Axagon6/OpenBook/Images/Image1.png

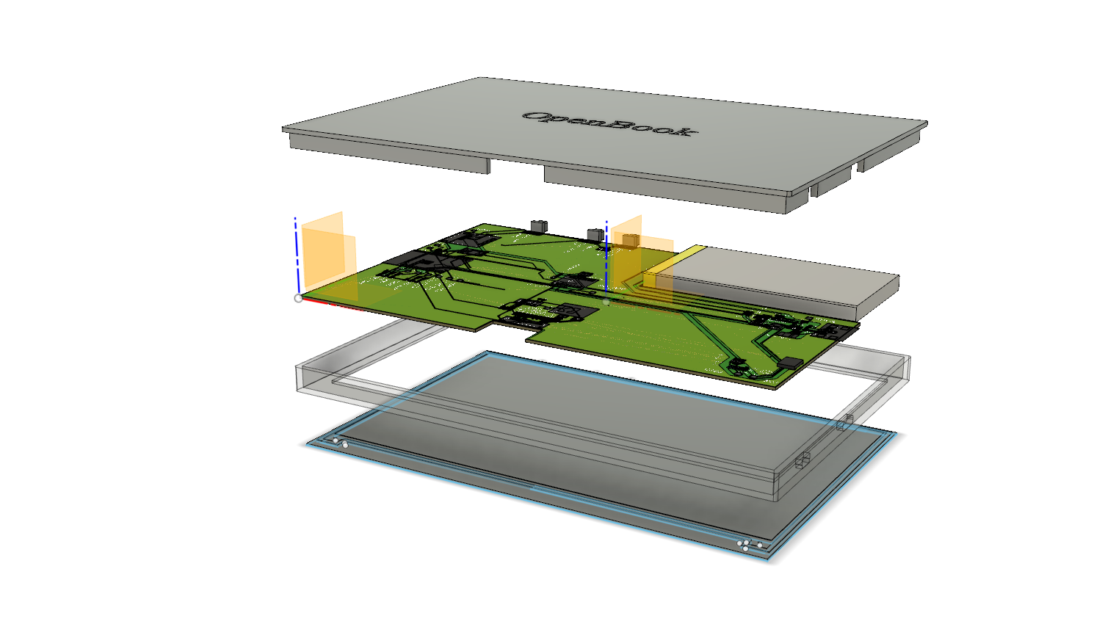
Images/Image1.png
