Axagon6/OpenBook/Images/Image2.png

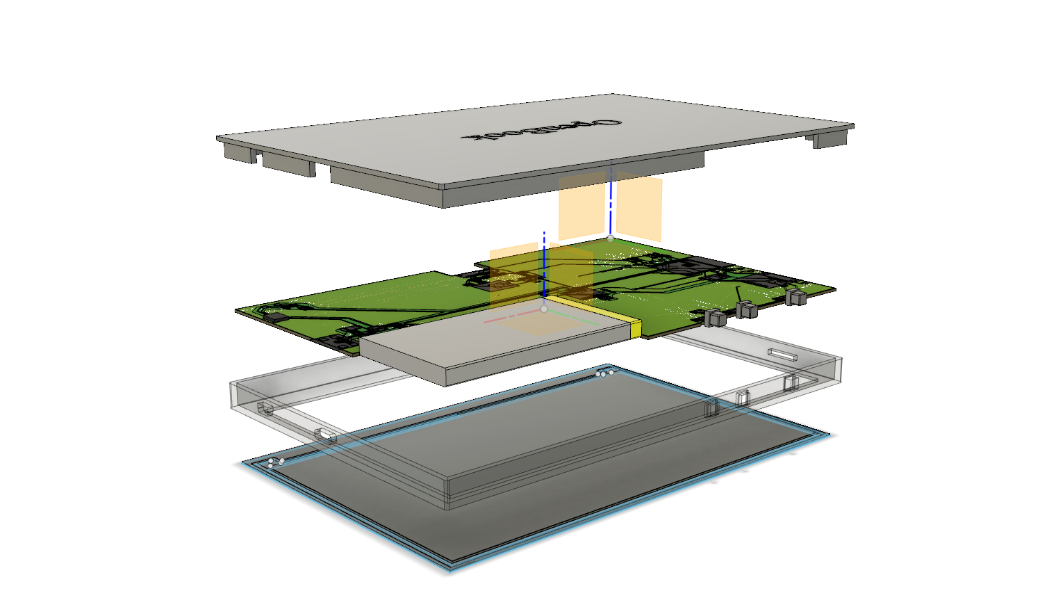
Images/Image2.png
