Axagon6/OpenBook/Images/Image3.png

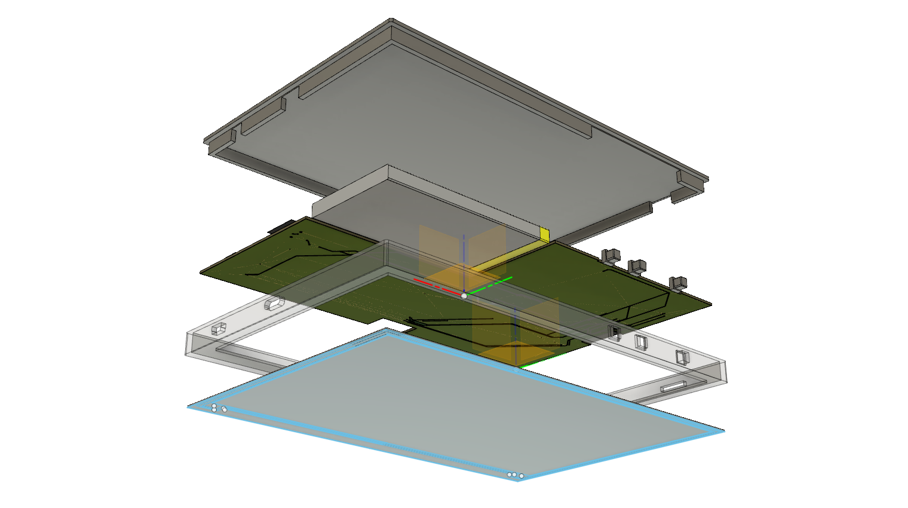
Images/Image3.png
