Axagon6/OpenBook/Manufacturing/BOM_E-book_PCB v25.txt

Partlist exported from Fusion Hub: Hub1   Project: TSC project  Board: E-book_PCB v25 at 06.04.2025 12:42

Qty Value                                                                          Device                                                                         Package                                                Parts                                                                                                                      Description                                                                                                                                                                                                                                                                                                                                                                                                                                                                                          ARROW_PART_NUMBER ARROW_PRICE-STOCK AVAILABILITY CENTROID_NOT_SPECIFIED CHECK_PRICES                                                                           COPYRIGHT                                                DATASHEET                              DESCRIPTION                                                                                        DIGIKEY_DESCRIPTION                                                                                                                                                                                                      DIGIKEY_PART_NUMBER                           HEIGHT                                                                                LEAD_FREE                                                          MANUFACTURER_NAME                 MANUFACTURER_PART_NUMBER MF                  MFR_NAME          MOUSER_PART_NUMBER    MOUSER_PRICE-STOCK                                                                                        MOUSER_TESTING_PART_NUMBER MOUSER_TESTING_PRICE-STOCK MP                                                                                                                  MPN                                                                                                  PACKAGE                     POPULARITY          PREFIX PRICE                        PROD_ID    PURCHASE-URL                                                                                                                                ROHS SNAPEDA_LINK                                                                       SPICEMODEL                                                                                                                                      SPICEPREFIX TEMPERATURE_RANGE_HIGH                                                                  TEMPERATURE_RANGE_LOW TP_SIGNAL_NAME VALUE             
1                                                                                  ADAFRUIT_LEDCHIP-LED0603                                                       ADAFRUIT_CHIP-LED0603                                  CHG_LED                                                                                                                    LED                                                                                                                                                                                                                                                                                                                                                                                                                                                                                                                                                                                                                                                                                                                                                                                                                                                                                                                                                                                                                                                                                                                                                                                                     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
1   BD5229G-TR                                                                     BD5229G-TR                                                                     SOT95P280X125-5N                                       IC1                                                                                                                        Voltage Detector with Adjustable Delay Time: CMOS processes are utilized to develop high precision, low current consumption CMOS reset ICs that allow arbitrary setting of the delay time. The extensive lineup includes both Nch Open Drain and CMOS output types in a wide range of detection voltages (from 2.3V to 6.0V, in 0.1V steps), enabling selection of the ideal solution based on customer requirements. In addition, the entire series is of course both lead-free and RoHS-compliant.                                                                                                                                                                                                                                                                Voltage Detector with Adjustable Delay Time: CMOS processes are utilized to develop high precision  low current consumption CMOS reset ICs that allow arbitrary setting of the delay time. The extensive lineup includes both Nch Open Drain and CMOS output types in a wide range of detection voltages (from 2.3V to 6.0V  in 0.1V steps)                                enabling selection of the ideal solution based on customer requirements. In addition  the entire series is of course both lead-free and RoHS-compliant.                                                            1.25mm                                ROHM Semiconductor    BD5229G-TR                                                                                                                                                      755-BD5229G-TR                                                                                                      https://www.mouser.co.uk/ProductDetail/ROHM-Semiconductor/BD5229G-TR?qs=4kLU8WoGk0vvnhrrYwdszw%3D%3D                                                                                                                                                                                                                                                                                                                                                                                                                                                                                                                                                                                                                                               
3   BUTTON_CUSYOMV1                                                                BUTTON_CUSYOMV1                                                                MYBUTTON                                               BOOT_BUTTON, CHANGE_BUTTON, RESET_BUTTON                                                                                                                                                                                                                                                                                                                                                                                                                                                                                                                                                                                                                                                                                                                                                                                                                                                                                                                                                                                                                                                                                                                                                                                                                                                                                                                                                                                                                                                                                                                                                                                                                                                                                                                                                                                                                                                                                                                                                                                                                                                                                                                                                                                                                                                                                                                                                                                                                                                                                                                                                        
1   CPH3225A                                                                       CPH3225A                                                                       CAPCP3225X100N                                         C10_SUPERCAP                                                                                                               Cap 0.011F 3.3V 1210 Flat Check availability                                                                                                                                                                                                                                                                                                                                                                                                                                                                                             Not in stock                        https://www.snapeda.com/parts/CPH3225A/Seiko+Instruments/view-part/?ref=eda                                                                                                             11 mF (EDLC) Supercapacitor 3.3 V 1210 (3225 Metric) - -                                                                                                                                                                                                                                                                                                                                                                                                                                                                                                                                     Seiko Instruments                                                                                                                                                                                                           CPH3225A                                                                                                                                                                                                                 1210 Seiko                                             None                                    https://www.snapeda.com/api/url_track_click_mouser/?unipart_id=562593&manufacturer=Seiko Instruments&part_name=CPH3225A&search_term=None         https://www.snapeda.com/parts/CPH3225A/Seiko+Instruments/view-part/?ref=snap                                                                                                                                                                                                                                                                                                                  
1   DS3231SN#                                                                      DS3231SN#                                                                      SOIC127P1032X265-16N                                   U3                                                                                                                         Real Time Clock Serial 16-Pin SOIC W T/R     Check availability                                                                                                                                                                                                                                                                                                                                                                                                                                                                          In Stock                            https://www.snapeda.com/parts/DS3231SN%23/Analog+Devices/view-part/?ref=eda                                                                                                             Extremely Accurate I²C-Integrated RTC/TCXO/Crystal                                                                                                                                                                                                                                                                                                                                                                                                                                                                                                                                           Analog Devices                                                                                                                                                                                                              DS3231SN#                                                                                                                                                                                                                SOIC-16 Maxim                                          None                                    https://www.snapeda.com/api/url_track_click_mouser/?unipart_id=99048&manufacturer=Analog Devices&part_name=DS3231SN#&search_term=None            https://www.snapeda.com/parts/DS3231SN%23/Analog+Devices/view-part/?ref=snap                                                                                                                                                                                                                                                                                                                  
1   ESP32-C6-WROOM-1-N8                                                            ESP32-C6-WROOM-1-N8                                                            XCVR_ESP32-C6-WROOM-1-N8                               U2                                                                                                                         Check availability                                                                                                                                                                                                                                                                                                                                                                                                                                                                                                                       In Stock                            https://www.snapeda.com/parts/ESP32-C6-WROOM-1-N8/Espressif+Systems/view-part/?ref=eda                                                                                                  Multiprotocol Modules ESP32-C6 module                                                              Wi-Fi 6 in 2.4 GHz band                                                                                                                                                                                                  Bluetooth 5                                   Zigbee 3.0 and Thread. ESP34-WROOM Compatible - ENGINEERING SAMPLE                                                                                                                                                                                                             Espressif Systems                                                                                                                                                                                                                                                                                                                                                                                                    ESP32-C6-WROOM-1-N8        None                                                                                                                                                                                None                                                                                                                                                                                                                                                https://www.snapeda.com/parts/ESP32-C6-WROOM-1-N8/Espressif+Systems/view-part/?ref=snap                                                        
1   ESP32C6_VARISTORCN1812                                                         ESP32C6_VARISTORCN1812                                                         ESP32C6_VARISTOR_CT/CN1812                             PFMF.05.1                                                                                                                  VARISTOR                                                                                                                                                                                                                                                                                                                                                                                                                                                                                                                                                                                                                                                                                                                                                                                                                                                                                                                                                                                                                                                                                                                                                                                                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
1   MAX17048G+T10                                                                  MAX17048G+T10                                                                  SON50P200X200X80-9N                                    U4                                                                                                                         Check availability                                                                                                                                                                                                                                                                                                                                                                                                                                                                                                                       In Stock                            https://www.snapeda.com/parts/MAX17048G+T10/Analog+Devices/view-part/?ref=eda                                                                                                           3µA 1-Cell/2-Cell Fuel Gauge with ModelGauge                                                                                                                                                                                                                                                                                                                                                                                                                                                                                                                                                 Analog Devices                                                                                                                                                                                                              MAX17048G+T10                                                                                                                                                                                                            TDFN-8 Maxim                                           None                                    https://www.snapeda.com/api/url_track_click_mouser/?unipart_id=329239&manufacturer=Analog Devices&part_name=MAX17048G+T10&search_term=None       https://www.snapeda.com/parts/MAX17048G+T10/Analog+Devices/view-part/?ref=snap                                                                                                                                                                                                                                                                                                                
3   MBR0530                                                                        MBR0530                                                                        SOD3716X135N                                           D3, D4, D5                                                                                                                 ON SEMICONDUCTOR - MBR0530 - DIODE, SCHOTTKY, 0.5A, 30V, SOD-123                                                                                                                                                                                                                                                                                                                                                                                                                                                                         In Stock                            https://www.snapeda.com/parts/MBR0530/Onsemi/view-part/?ref=eda                                                                                                                         Diode Schottky 30 V 500mA Surface Mount SOD-123                                                                                                                                                                                                                                                                                                                                                                                                                                                                                                                                              ON Semiconductor                                                                                                                                                                                                            MBR0530                                                                                                                                                                                                                  SOD-123-2 ON Semiconductor                             None                                    https://www.snapeda.com/api/url_track_click_mouser/?unipart_id=179458&manufacturer=ON Semiconductor&part_name=MBR0530&search_term=None           https://www.snapeda.com/parts/MBR0530/Onsemi/view-part/?ref=snap                                                                                                                                                                                                                                                                                                                              
6   PGB1010603MR                                                                   PGB1010603MR                                                                   DIOC1608X36N                                           SPI-D1, SPI-D2, SPI-D3, SPI-D4, SPI-D5, SPI-D6                                                                             Check availability                                                                                                                                                                                                                                                                                                                                                                                                                                                                                                                       In Stock                            https://www.snapeda.com/parts/PGB1010603MR/Littelfuse/view-part/?ref=eda                                                                                                                150V (Typ) Clamp - Ipp Tvs Diode Surface Mount 0603 (1608 Metric)                                                                                                                                                                                                                                                                                                                                                                                                                                                                                                                            Littelfuse Inc.                                                                                                                                                                                                             PGB1010603MR                                                                                                                                                                                                             0603 Littelfuse Inc.                                   None                                    https://www.snapeda.com/api/url_track_click_mouser/?unipart_id=5659453&manufacturer=Littelfuse Inc.&part_name=PGB1010603MR&search_term=None      https://www.snapeda.com/parts/PGB1010603MR/Littelfuse/view-part/?ref=snap                                                                                                                                                                                                                                                                                                                     
1   QWIIC_RIGHT_ANGLE                                                              QWIIC_CONNECTORJS-1MM                                                          JST04_1MM_RA                                           J3                                                                                                                         SparkFun I2C Standard Qwiic Connector                                                                                                                                                                                                                                                                                                                                                                                                                                                                                                                                                                                                                                                                                                                                                                                                                                                                                                                                                                                                                                                                                                                                                                                                                                                                                                                                                                                                                                                                                                                                                                                                                                                                                                                                                                                                                                                                      CONN-13694                                                                                                                                                                                                                                                                                                                                                                                                                                                                                                                              QWIIC_RIGHT_ANGLE 
1   SI1308EDL-T1-GE3                                                               SI1308EDL-T1-GE3                                                               SOT65P210X110-3N                                       Q3                                                                                                                         MOSFET N-Ch 30V 1.5A TrenchFET SC70 Vishay Si1308EDL-T1-GE3 N-channel MOSFET Transistor, 1.5 A, 30 V, 3-Pin SC-70                                                                                                                                                                                                                                                                                                                                                                                                                        In Stock                            https://www.snapeda.com/parts/SI1308EDL-T1-GE3/Vishay+Siliconix/view-part/?ref=eda                                                                                                      Si1308EDL-T1-GE3 N-channel MOSFET Transistor                                                       1.5 A                                                                                                                                                                                                                    30 V                                          3-Pin SC-70 | Siliconix / Vishay SI1308EDL-T1-GE3                                                                                                                                                                                                                              Vishay Siliconix                                                                                                                                                                                                                                                                                                                                                                                                     SI1308EDL-T1-GE3           SOT-323 Vishay Semiconductor                                                                                                                                                        None                                                                                    https://www.snapeda.com/api/url_track_click_mouser/?unipart_id=274603&manufacturer=Vishay Siliconix&part_name=SI1308EDL-T1-GE3&search_term=None             https://www.snapeda.com/parts/SI1308EDL-T1-GE3/Vishay+Siliconix/view-part/?ref=snap                                                            
17  TPTP20R                                                                        TPTP20R                                                                        TP20R                                                  TP1, TP2, TP3, TP4, TP5, TP6, TP7, TP8, TP9, TP10, TP11, TP12, TP13, TP14, TP15, TP16, TP17                                Test pad                                                                                                                                                                                                                                                                                                                                                                                                                                                                                                                                                                                                                                                                                                                                                                                                                                                                                                                                                                                                                                                                                                                                                                                                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
1   XC6220A331MR-G                                                                 XC6220A331MR-G                                                                 SOT95P280X120-5N                                       IC4                                                                                                                        LDO Voltage Regulators                                                                                                                                                                                                                                                                                                                                                                                                                                                                                                                                                                                                                                                                                                                                              LDO Voltage Regulators                                                                                                                                                                                                                                                                                                                                                    1.2mm                                                                                                                                                    Torex                             XC6220A331MR-G                                                 865-XC6220A331MR-G    https://www.mouser.co.uk/ProductDetail/Torex-Semiconductor/XC6220A331MR-G?qs=AsjdqWjXhJ8ZSWznL1J0gg%3D%3D
