Axagon6/OpenBook/(threads)

Thread 1 (2025-04-11):

Lipsa fisier 3D dispozitiv

COSSS02, 2025-04-11:
Fisierele 3D incarcate cuprind doar PCB-ul si exploded view. Trebuie adaugat un fisier 3D cu toate componentele in interiorul carcasei.

Axagon6, 2025-04-11:
Te referi la conținutul folderului Mechanical?
Fisierul _OpenBook Enclosure exploded v2.step_ cuprinde toate componnentele: PCB + baterie + carcasă + display.

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

COSSS02, 2025-04-11:
Nu, ma refeream la fisierul E-book v34.f3z din folderul Mechanical. Acesta contine doar modelul 3D al PCB-ului, dar ar trebui sa cuprinda PCB-ul, Display-ul si Bateria in interiorul carcasei.

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

Axagon6, 2025-04-11:
OK, am înțeles acum. S-a remediat.

Closed 2025-04-11.

Thread 3 (2025-04-11):

Text neclar pe layer-ul de silkscreen

COSSS02, 2025-04-11:
Exista zone pe modelul 3D al PCB-ului unde textul nu este citet deoarece este acoperit de componente sau se suprapune cu textul de la componentele adiacente.

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

Axagon6, 2025-04-11:
Remediat poziție, dimensiune și orientare denumiri componente.

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

Closed 2025-04-11.
