Axagon6/OpenBook/(notices)

Notices in the files:
parts and their libraries:
DeskAssistant v19 v1: COPYRIGHT: Copyright (C) 2024 Ultra Librarian. All rights reserved.
